theozor/EnvModulePCB/PCB/IOT_PCB/Img/IOT_PCB.png

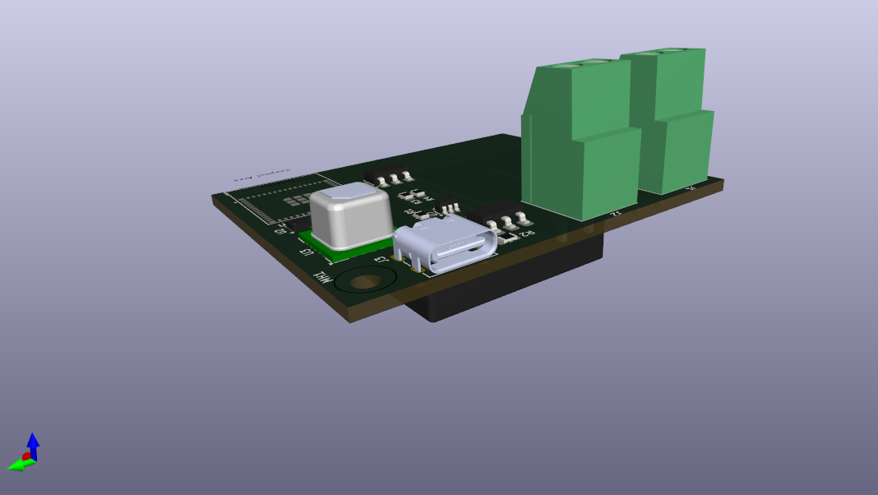
PCB/IOT_PCB/Img/IOT_PCB.png
