theozor/EnvModulePCB/README.md

# THP-Modul
 
Välj komponenter i följande prio:

1. BME280
2. SEN54
3. ENS160
4. SCD42
