theozor/EnvModulePCB/PCB/IOT_PCB/PDF/IOT_PCB__Assembly-2025-02-09.pdf

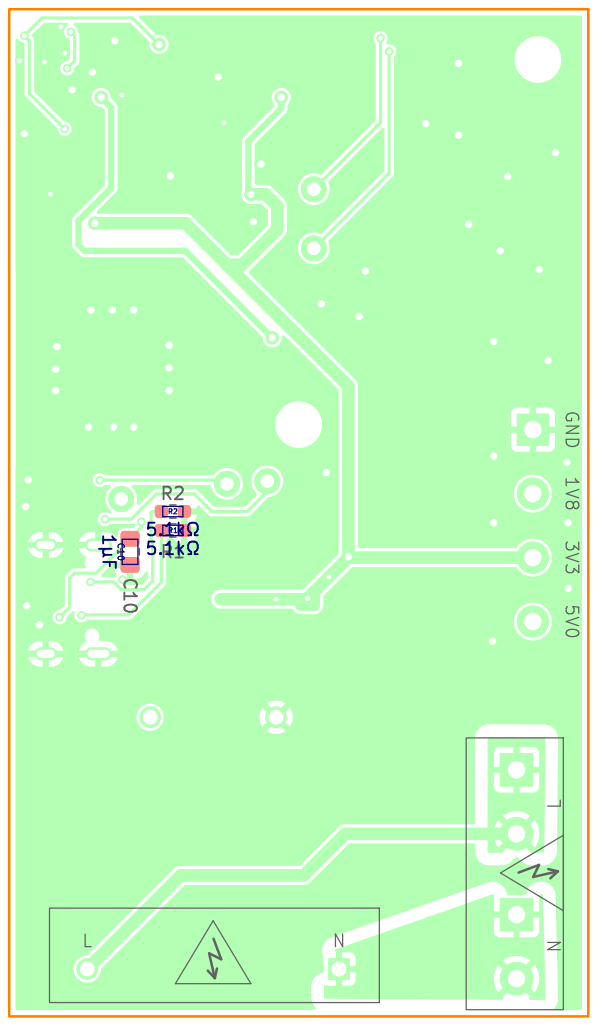
[picture p2: page 1]
GND L 3V3 C10; D Date: 2025-02-09 KiCad; E.D.A. 8.0.5 Size: A4; Rev: A; File: IOT_PCB.kicad_pcb Sheet: Theofil; Eriksson; Petrovski ¹µFC10

Id: 1/1 Title: Environmental Sensing Module

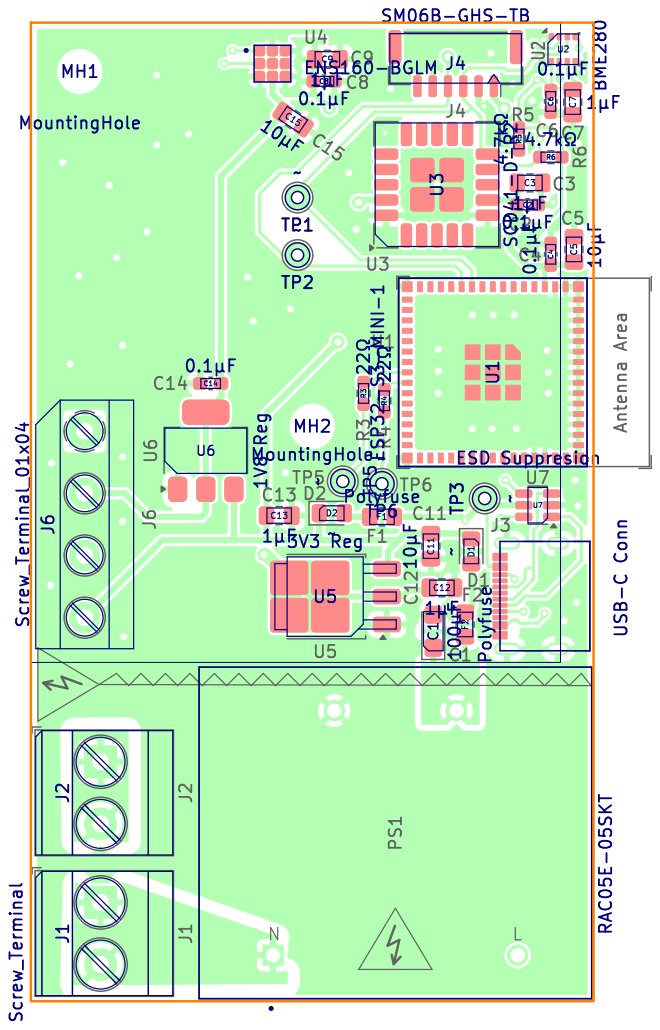
[picture p3: page 2]

Id: 1/1 Title: Environmental Sensing Module
