theozor/EnvModulePCB/PCB/IOT_PCB/PDF/IOT_PCB__Assembly-2024-10-21.pdf

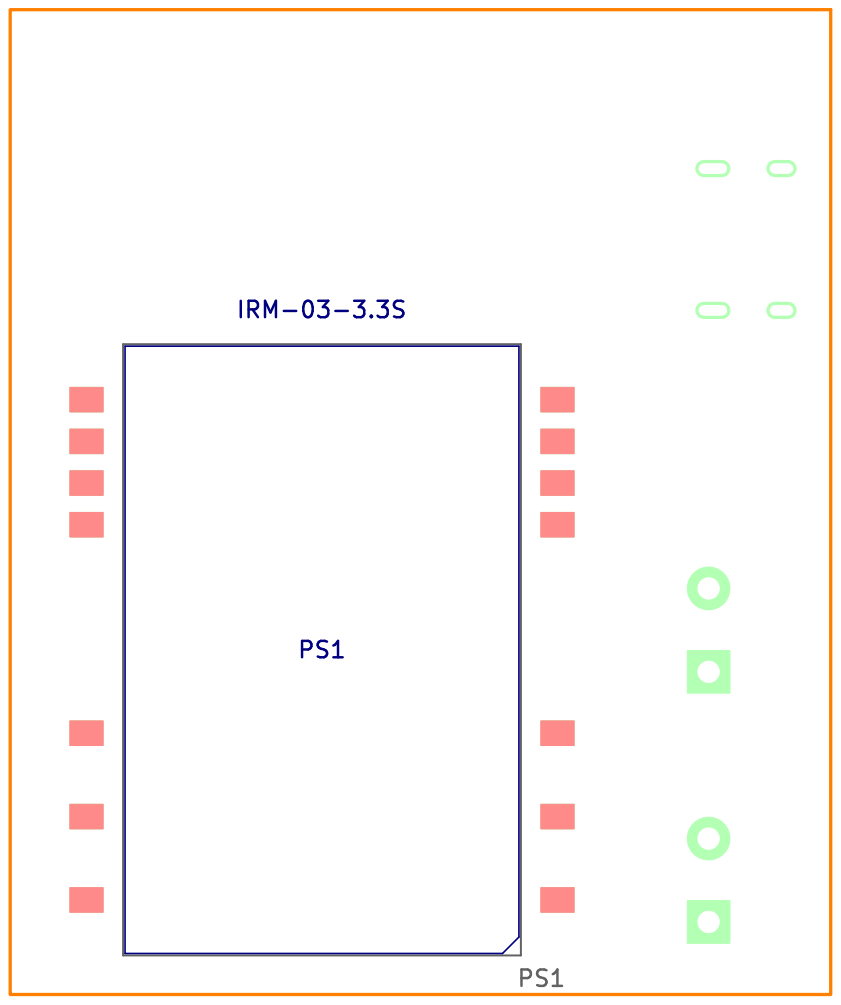
[picture p4: page 1]
D Date: 2024-10-16 KiCad; E.D.A. 8.0.5 Size: A4; Rev: A; Id: 1/1 Title: Miljömodul File: IOT_PCB.kicad_pcb Sheet: Theofil; Eriksson; Petrovski WORK; PROGRESS; IRM-03-3.3S

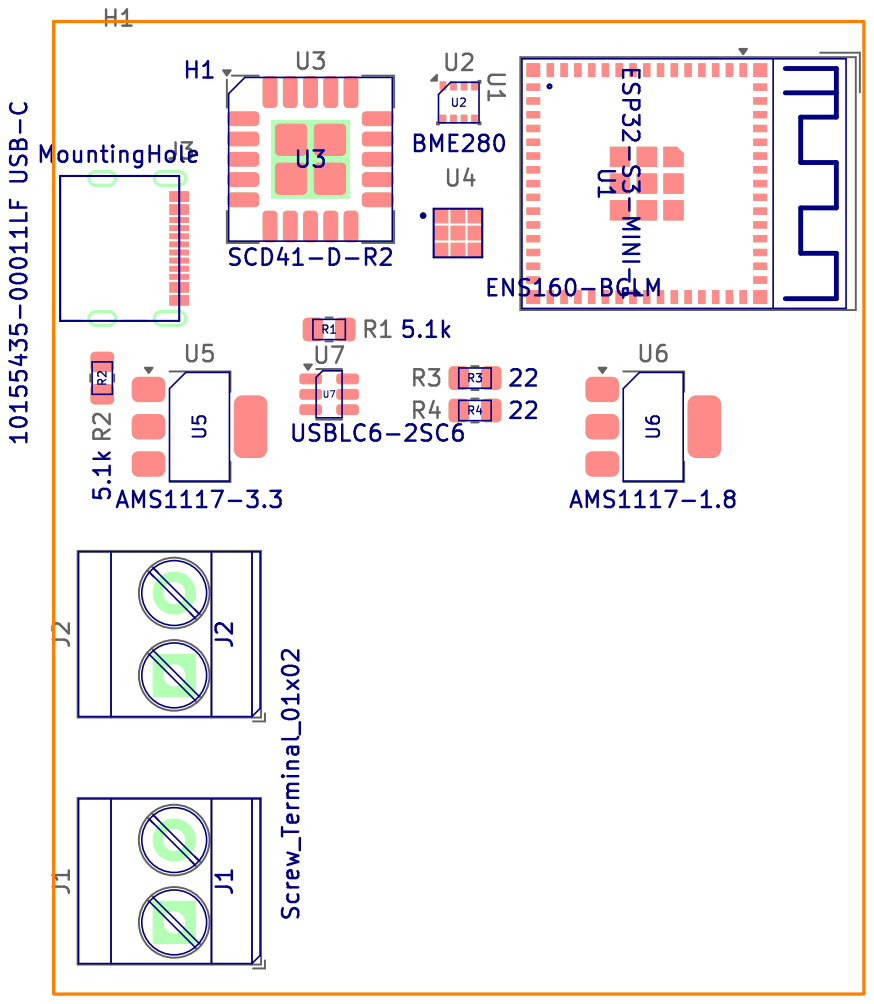
[picture p5: page 2]
