theozor/EnvModulePCB/PCB/IOT_PCB/PDF/IOT_PCB.pdf

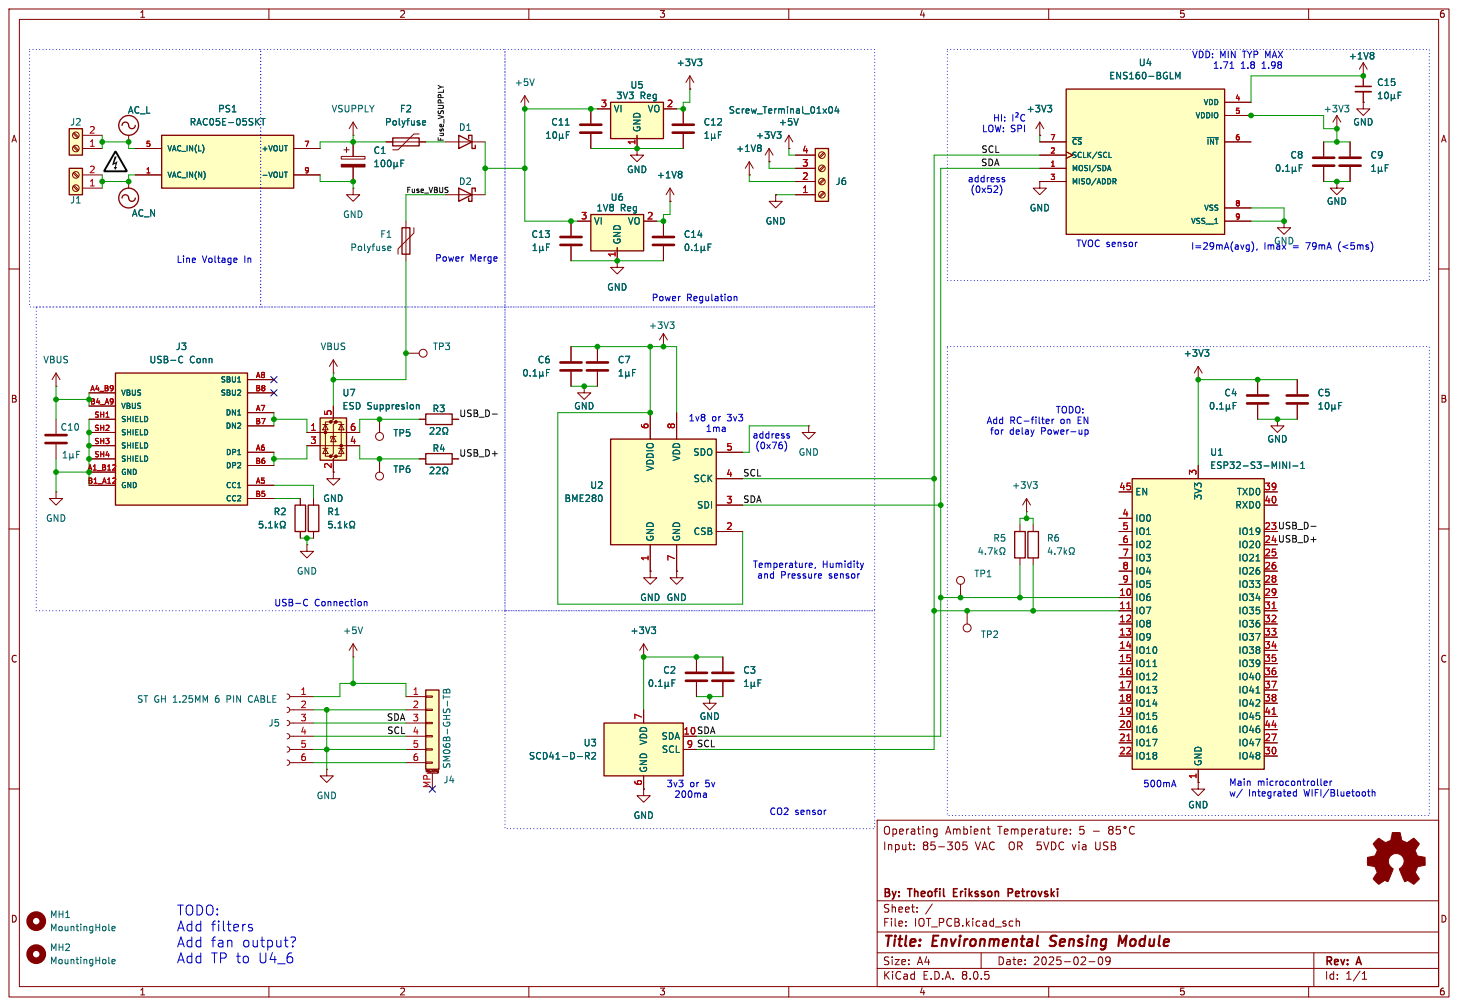
[picture p6: page 1]

for delay Power-up Power Regulation

1 CSB 2 SDI 3 SCK 4 SDO 5 VDDIO

J5 ST GH 1.25MM 6 PIN CABLE

Id: 1/1 Title: Environmental Sensing Module
