theozor/EnvModulePCB/PCB/IOT_PCB/PDF/IOT_PCB__Schematic-2025-02-09.pdf

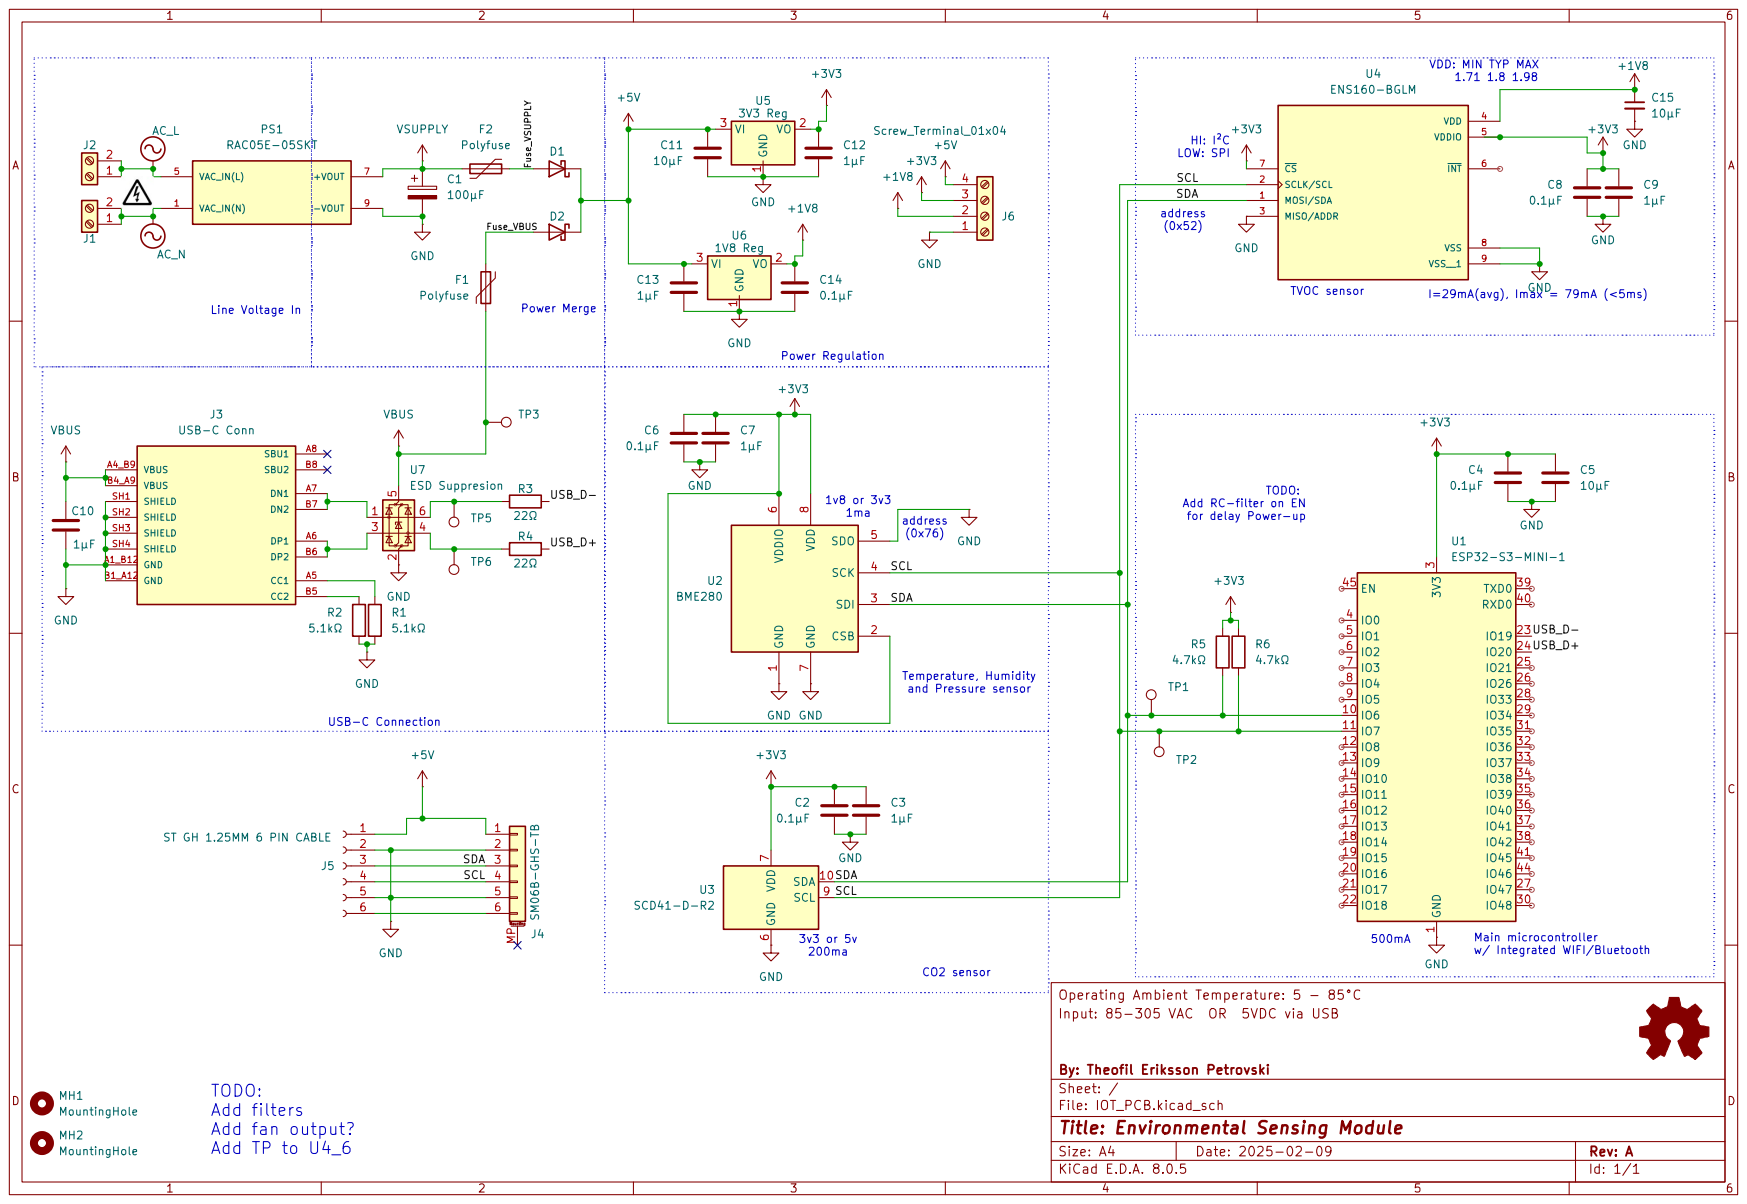
[picture p7: page 1]
