theozor/EnvModulePCB/PCB/IOT_PCB/PDF/IOT_PCB__Schematic-2024-10-22.pdf

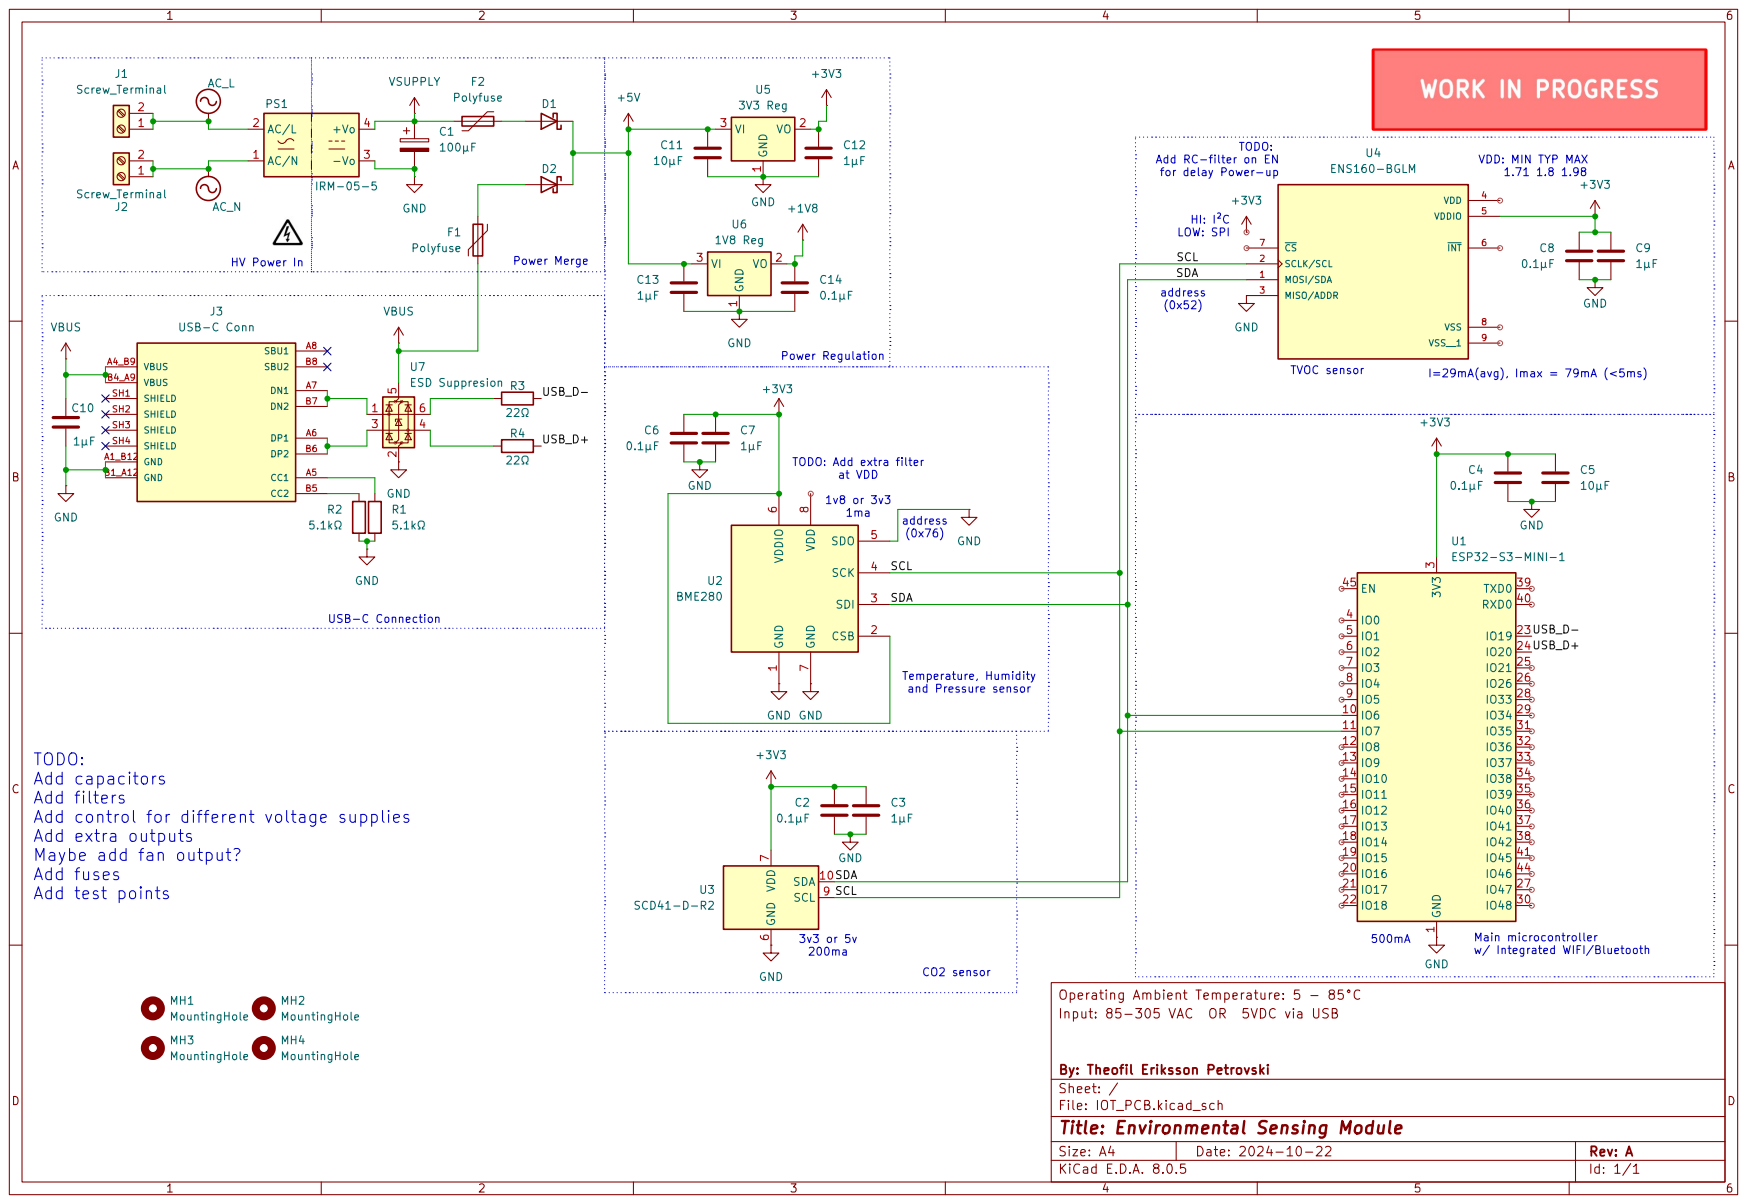
[picture p8: page 1]
