theozor/EnvModulePCB/PCB/IOT_PCB/PDF/IOT_PCB__Schematic-2024-10-21.pdf

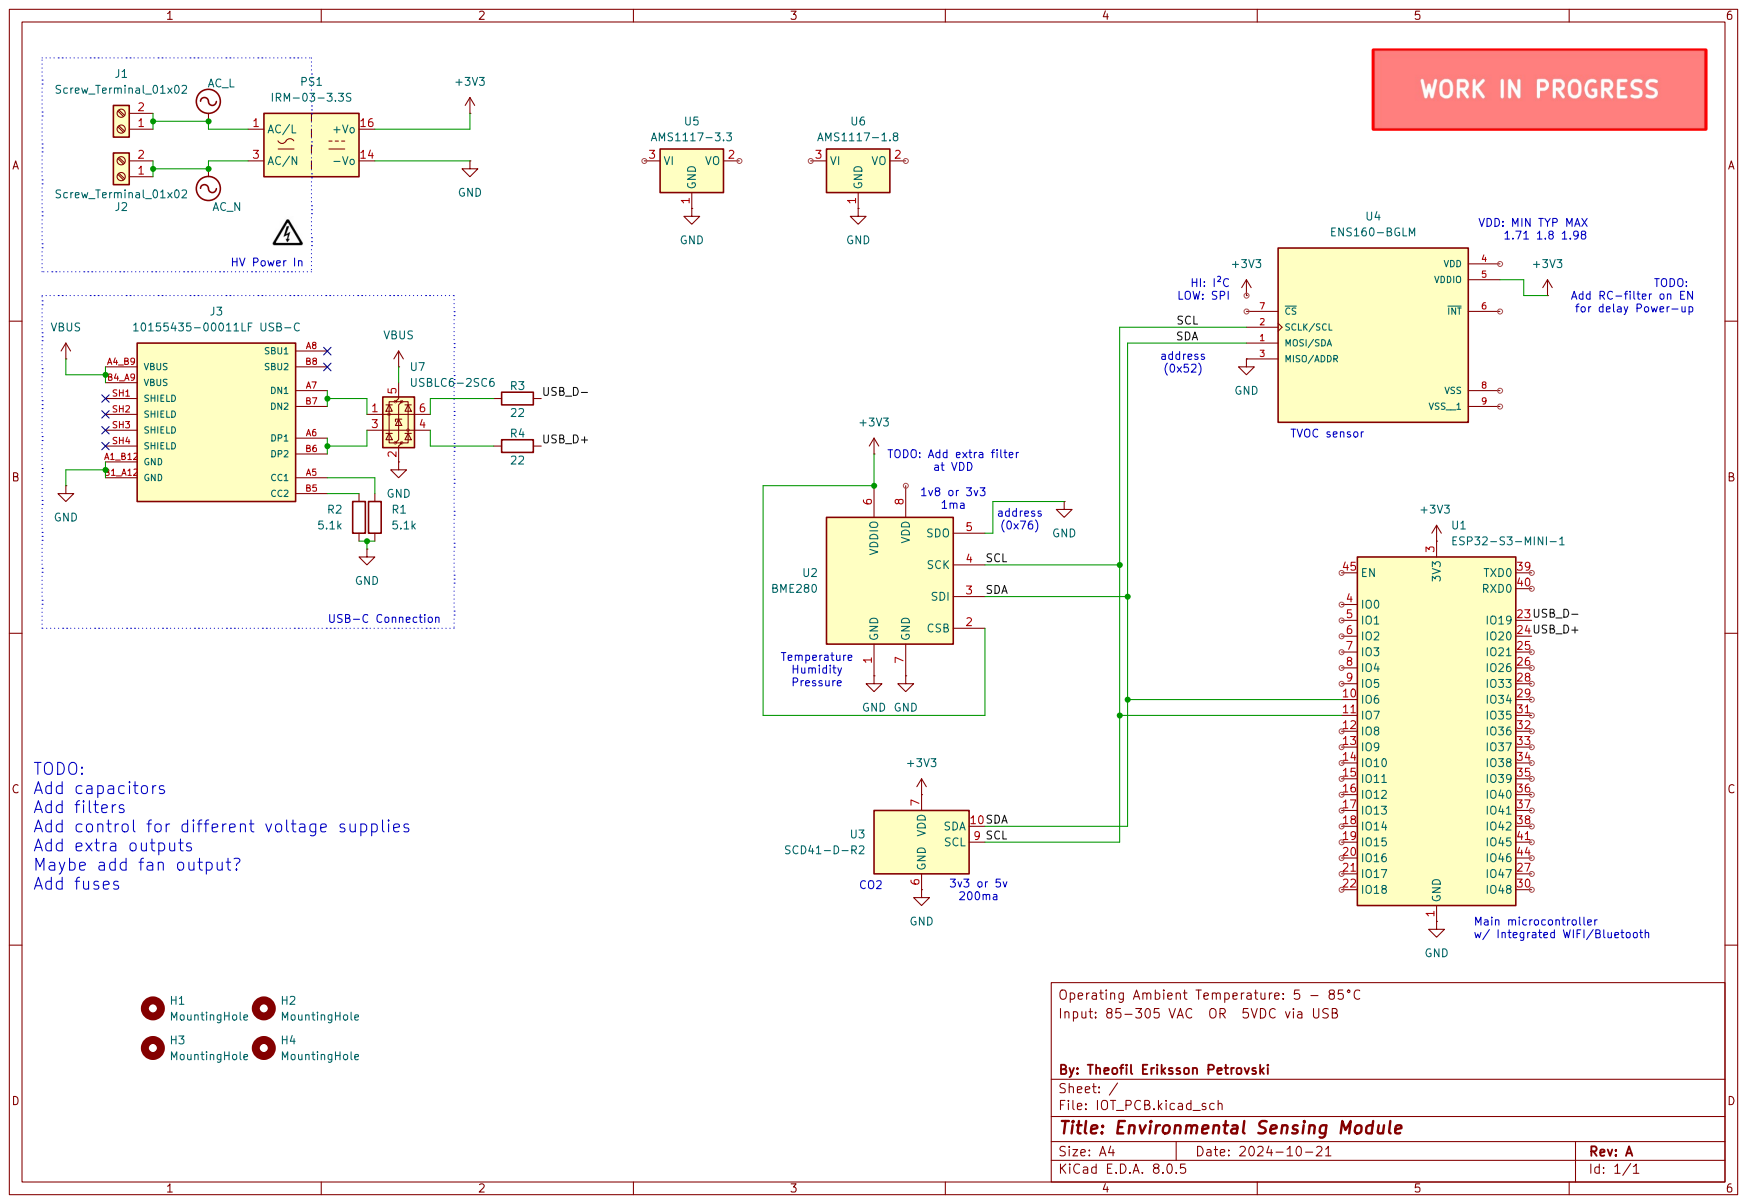
[picture p9: page 1]
