theozor/EnvModulePCB/PCB/IOT_PCB/IOT_PCB.kicad_pcb

## KiCad design PCB/IOT_PCB/IOT_PCB.kicad_pcb (2025-02-09)

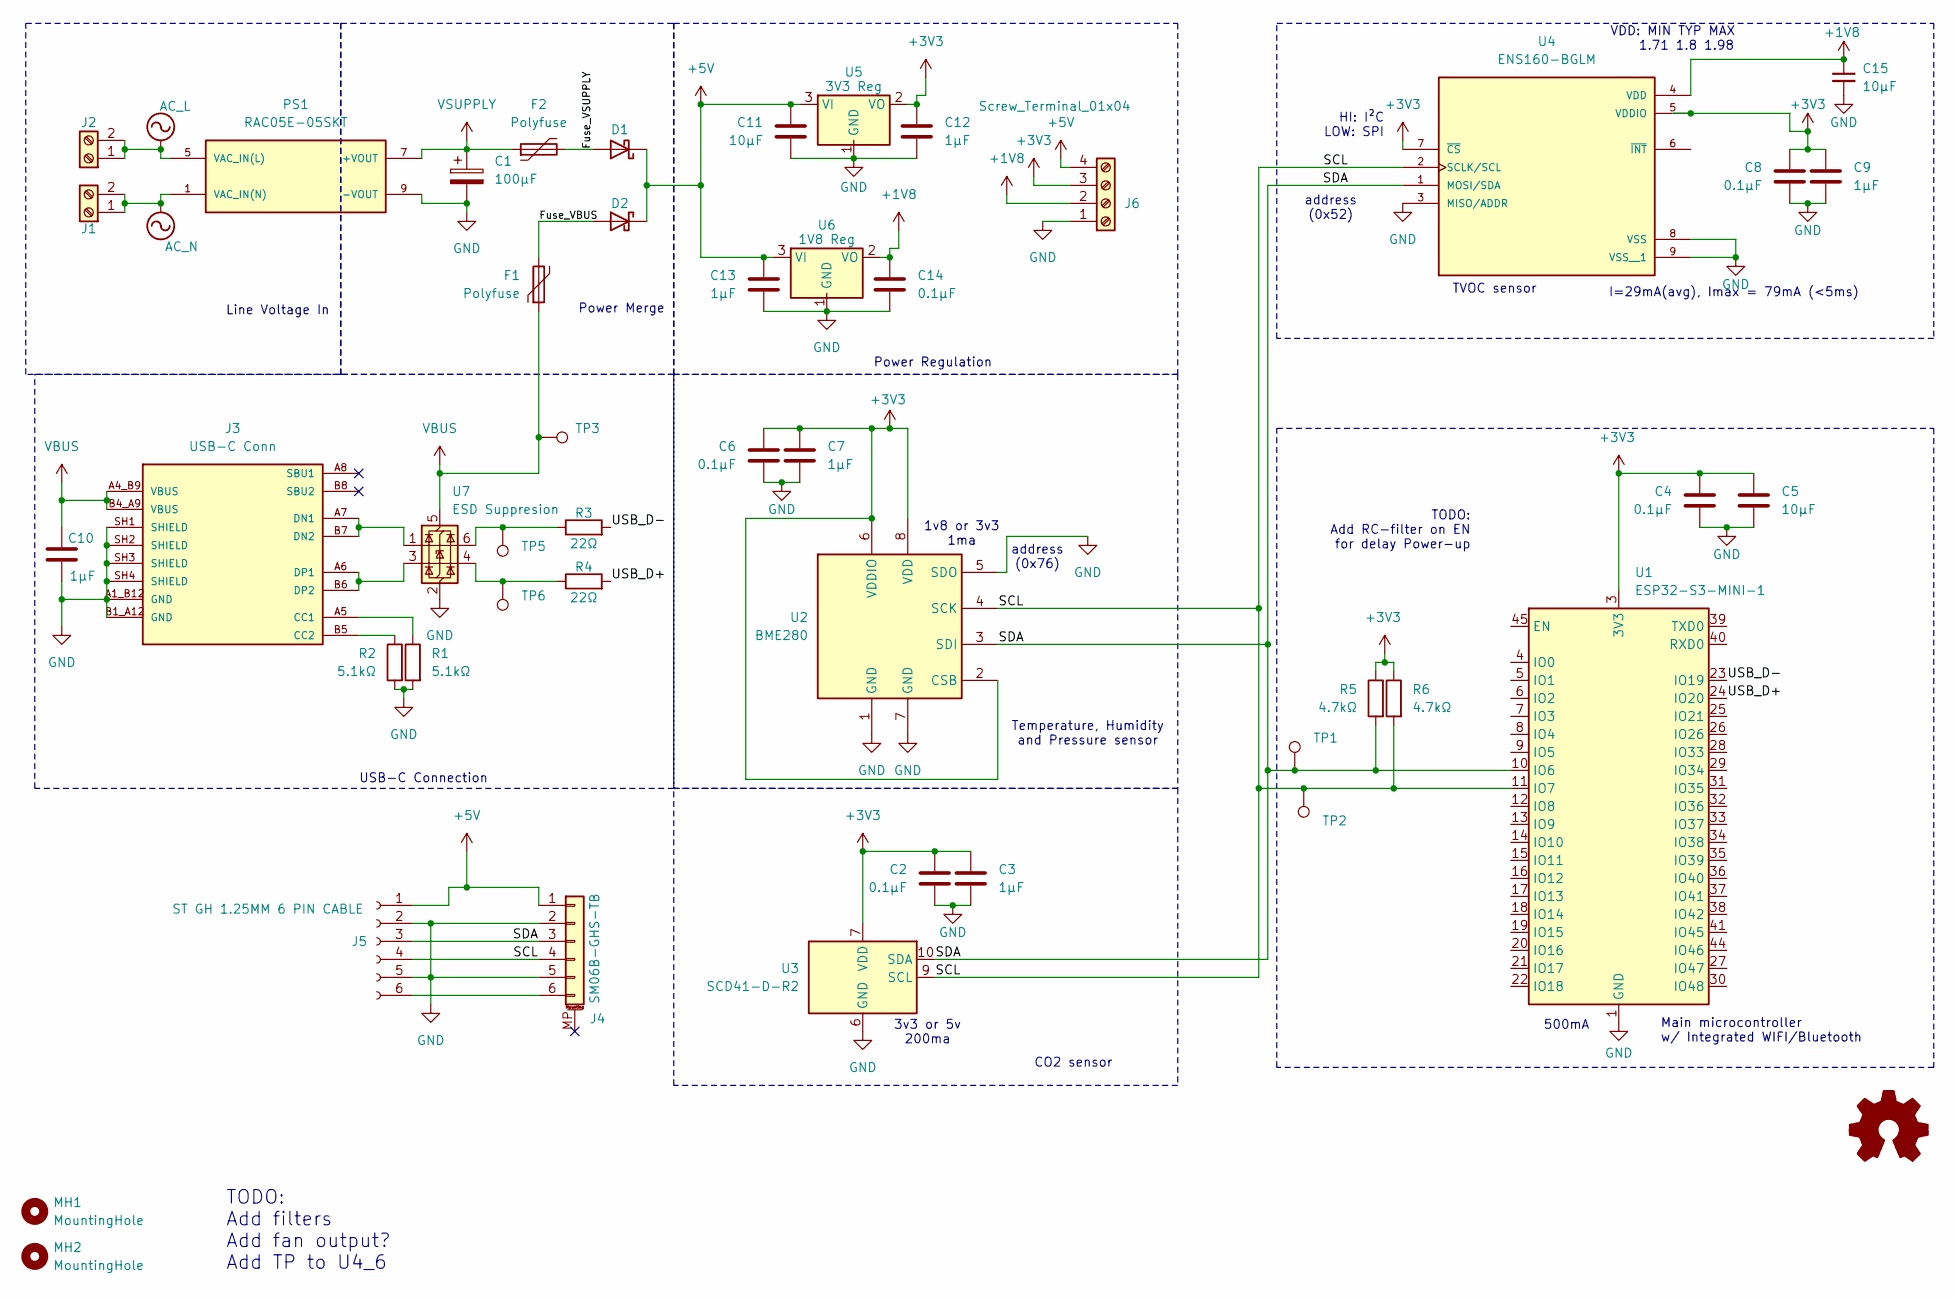
[picture p10: schematic IOT_PCB.kicad_sch, Environmental Sensing Module]

Parts:
C1: 100µF; CP_EIA-3216-12_Kemet-S
C2, C4, C6, C8, C14: 0.1µF; C_0603_1608Metric_Pad1.08x0.95mm_HandSolder
C3, C7, C9, C10, C12, C13: 1µF; C_0805_2012Metric_Pad1.18x1.45mm_HandSolder
C5, C11, C15: 10µF; C_0805_2012Metric_Pad1.18x1.45mm_HandSolder
D1, D2: D_0805_2012Metric_Pad1.15x1.40mm_HandSolder
F1, F2: Polyfuse; R_0805_2012Metric_Pad1.20x1.40mm_HandSolder
J1, J2: Screw_Terminal; TerminalBlock_Phoenix_MKDS-3-2-5.08_1x02_P5.08mm_Horizontal
J3: USB-C Conn; AMPHENOL_10155435-00011LF; PARTREV C; Mouser No 649-1015543500011LF
J4: SM06B-GHS-TB; JST_GH_SM06B-GHS-TB_1x06-1MP_P1.25mm_Horizontal; Mouser No 306-SM06BGHSTBLFSN
J5: ST GH 1.25MM 6 PIN CABLE; Mouser No 485-5754
J6: Screw_Terminal_01x04; TerminalBlock_MetzConnect_Type101_RT01604HBWC_1x04_P5.08mm_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
MH1, MH2: MountingHole; MountingHole_3.2mm_M3
PS1: RAC05E-05SKT; CONV_RAC05E-05SKT; PARTREV 0/2021; Mouser No 919-RAC05E-05SKT
R1, R2: 5.1kΩ; R_0603_1608Metric_Pad0.98x0.95mm_HandSolder
R3, R4: 22Ω; R_0603_1608Metric_Pad0.98x0.95mm_HandSolder
R5, R6: 4.7kΩ; R_0603_1608Metric_Pad0.98x0.95mm_HandSolder
TP1, TP2, TP3, TP5, TP6: Pin_D1.0mm_L10.0mm
U1: ESP32-S3-MINI-1; ESP32-S2-MINI-1; Mouser No 356-ESP32-S3-MINI1N8
U2: BME280; Bosch_LGA-8_2.5x2.5mm_P0.65mm_ClockwisePinNumbering; Mouser No 262-BME280
U3: SCD41-D-R2; Sensirion_SCD4x-1EP_10.1x10.1mm_P1.25mm_EP4.8x4.8mm; Mouser No 403-SCD41-D-R2
U4: ENS160-BGLM; XDCR_ENS160-BGLM; PARTREV 1.3; Mouser No ENS160-BGLT
U5: 3V3 Reg; TO-252-3_TabPin2; Mouser No 595-TLV76133KVUR
U6: 1V8 Reg; SOT-223-3_TabPin2; Mouser No 595-TLV76118DCYR
U7: ESD Suppresion; SOT-23-6; Mouser No 511-USBLC6-2SC6

Connections:
+1V8: C14.1, C15.1, J6.2, U4.4 (VDD), U6.2 (VO)
+3V3: C2.1, C3.1, C4.1, C5.1, C6.1, C7.1, C8.1, C9.1, C12.1, J6.3, R5.1, R6.1, U1.3 (3V3), U2.2 (CSB), U2.6 (VDDIO), U2.8 (VDD), U3.7 (VDD), U3.19 (VDD), U4.5 (VDDIO), U4.7 (~CS), U5.2 (VO)
+5V: C11.1, C13.1, D1.1 (K), D2.1 (K), J4.1, J5.1, J6.4, U5.3 (VI), U6.3 (VI)
/Fuse_VBUS: D2.2 (A), F1.2
/Fuse_VSUPPLY: D1.2 (A), F2.2
/SCL: J4.4, J5.4, R6.2, TP2.1, U1.11 (IO7), U2.4 (SCK), U3.9 (SCL), U4.2 (SCLK/SCL)
/SDA: J4.3, J5.3, R5.2, TP1.1, U1.10 (IO6), U2.3 (SDI), U3.10 (SDA), U4.1 (MOSI/SDA)
/USB_D+: R4.2, U1.24 (IO20)
/USB_D-: R3.2, U1.23 (IO19)
AC_L: J2.1, J2.2, PS1.5 (VAC_IN(L))
AC_N: J1.1, J1.2, PS1.1 (VAC_IN(N))
GND: C1.2, C2.2, C3.2, C4.2, C5.2, C6.2, C7.2, C8.2, C9.2, C10.2, C11.2, C12.2, C13.2, C14.2, C15.2, J3.A1_B12 (GND), J3.B1_A12 (GND), J3.SH1 (SHIELD), J3.SH2 (SHIELD), J3.SH3 (SHIELD), J3.SH4 (SHIELD), J4.2, J4.5, J5.2, J5.5, J6.1, PS1.9 (-VOUT), R1.2, R2.2, U1.1 (GND), U1.2 (GND), U1.42 (GND), U1.43 (GND), U1.46 (GND), U1.47 (GND), U1.48 (GND), U1.49 (GND), U1.50 (GND), U1.51 (GND), U1.52 (GND), U1.53 (GND), U1.54 (GND), U1.55 (GND), U1.56 (GND), U1.57 (GND), U1.58 (GND), U1.59 (GND), U1.60 (GND), U1.61 (GND), U1.62 (GND), U1.63 (GND), U1.64 (GND), U1.65 (GND), U2.1 (GND), U2.5 (SDO), U2.7 (GND), U3.6 (GND), U3.20 (GND), U3.21 (GND), U4.3 (MISO/ADDR), U4.8 (VSS), U4.9 (VSS__1), U5.1 (GND), U6.1 (GND), U7.2 (GND)
unnamed: J3.A5 (CC1), R1.1
unnamed: J3.B5 (CC2), R2.1
unnamed: J3.A7 (DN1), J3.B7 (DN2), U7.1 (I/O1)
unnamed: J3.A6 (DP1), J3.B6 (DP2), U7.3 (I/O2)
unnamed: J4.6, J5.6
unnamed: R3.1, TP5.1, U7.6 (I/O1)
unnamed: R4.1, TP6.1, U7.4 (I/O2)
VBUS: C10.1, F1.1, J3.A4_B9 (VBUS), J3.B4_A9 (VBUS), TP3.1, U7.5 (VBUS)
VSUPPLY: C1.1, F2.1, PS1.7 (+VOUT)

Notes on the sheet:
Line Voltage In
TVOC sensor
500mA
Power Merge
Power Regulation
CO2 sensor
address (0x52)
address (0x76)
Temperature, Humidity and Pressure sensor
TODO: Add RC-filter on EN for delay Power-up
Main microcontroller w/ Integrated WIFI/Bluetooth
3v3 or 5v 200ma
VDD: MIN TYP MAX 1.71 1.8 1.98
HI: I²C LOW: SPI
TODO: Add filters Add fan output? Add TP to U4_6
1v8 or 3v3 1ma
USB-C Connection
I=29mA(avg), Imax = 79mA (<5ms)

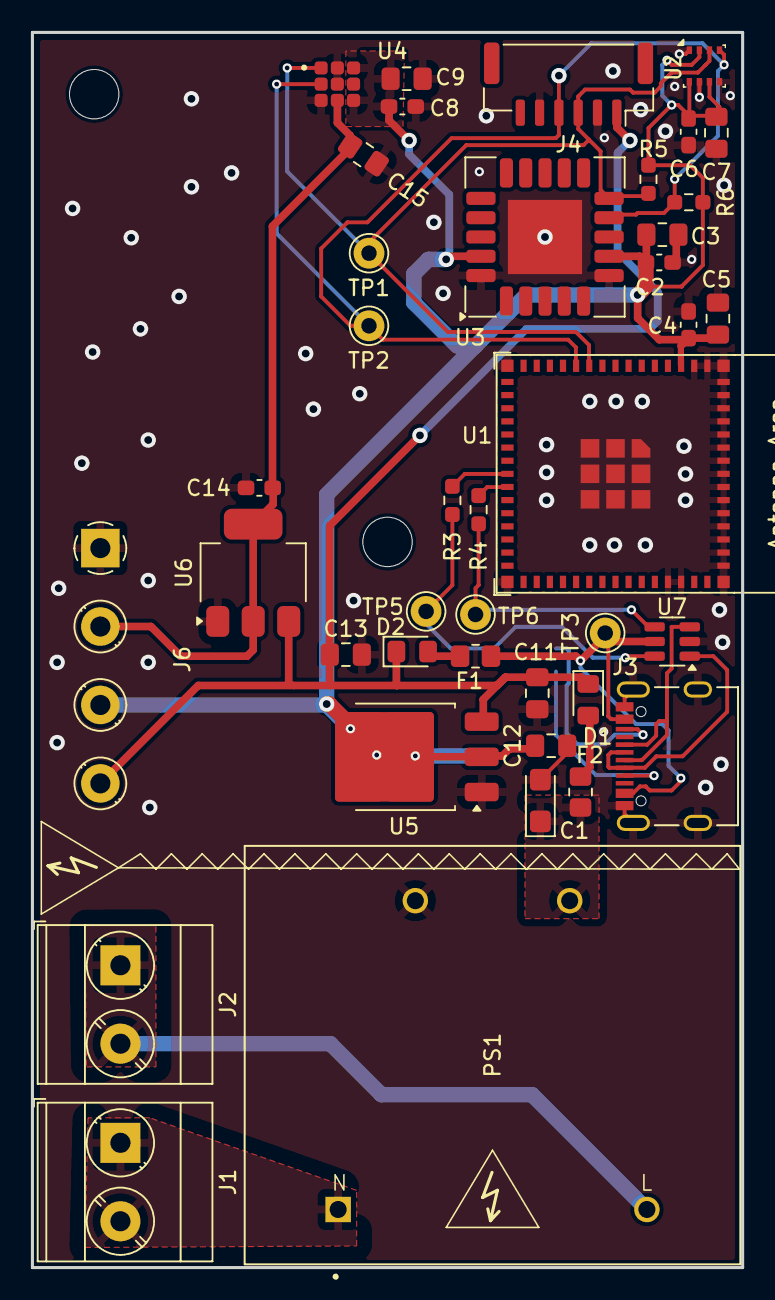
[picture p11: board IOT_PCB.kicad_pcb from above]

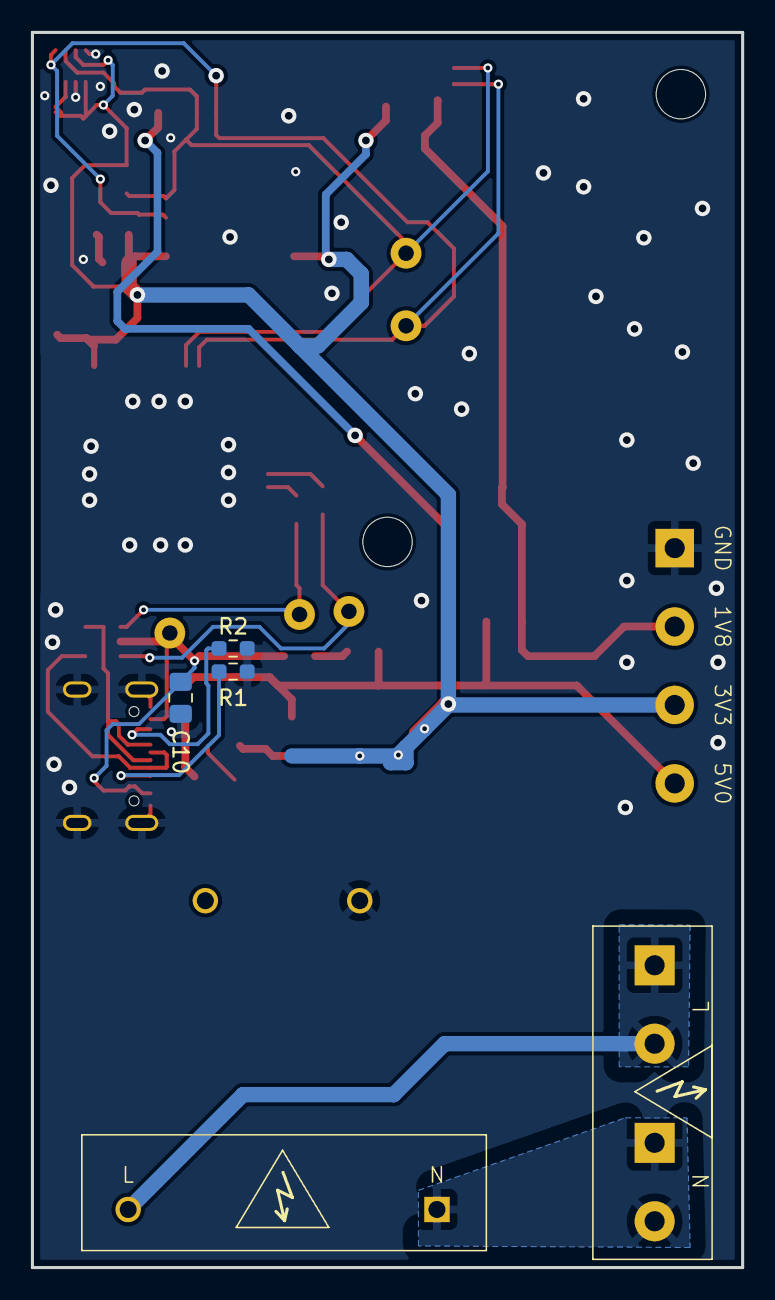
[picture p12: board IOT_PCB.kicad_pcb from below]

Board: 2 copper layers, 46.0 x 80.0 mm, 45 parts (3 on the bottom side), 20 nets.
