theozor/EnvModulePCB/(commit log)

2024-10-16 Rough component placement and schematic WIP
    [IOT_PCB.kicad_pcb, IOT_PCB.kicad_sch]
2024-10-20 Vreg and ESD suppresion
    [IOT_PCB.kicad_sch, Jämförelse Komponenter.xlsx]
2024-10-20 Changed IRM footprint to SMD
    [IOT_PCB.kicad_pcb]
2024-10-21 Shrunk Board
    [IOT_PCB.kicad_pcb, IOT_PCB.kicad_sch, IOT_PCB_BOMcsv.csv]
2024-10-21 Interactive BOM
2024-10-21 Fixed Interactive BOM
2024-10-22 Power mannagement
    Changed to beefier 5V supply instead of 3V3. Combined 5V supply with USB using diodes. Added caps and fuses.
    [IOT_PCB.kicad_pcb, IOT_PCB.kicad_sch]
2024-10-22 Updated interactive BOM
2024-10-24 Changed Power Supply
    Power supply changed from Mean Well to RECOM
    [IOT_PCB.kicad_pcb, IOT_PCB.kicad_sch]
2025-02-09 Finalized Design (Rev A)
    [IOT_PCB.kicad_pcb, IOT_PCB.kicad_sch]
2025-02-09 Add STEP file
    [IOT_PCB.kicad_pcb]
